warhog/fpvlaptracker-hardware/README.md

# fpvlaptracker-hardware
Hardware section of the fpvlaptracker project

**the current active project is fpvlaptracker32**
