warhog/fpvlaptracker-hardware/fpvlaptracker/schematics.png

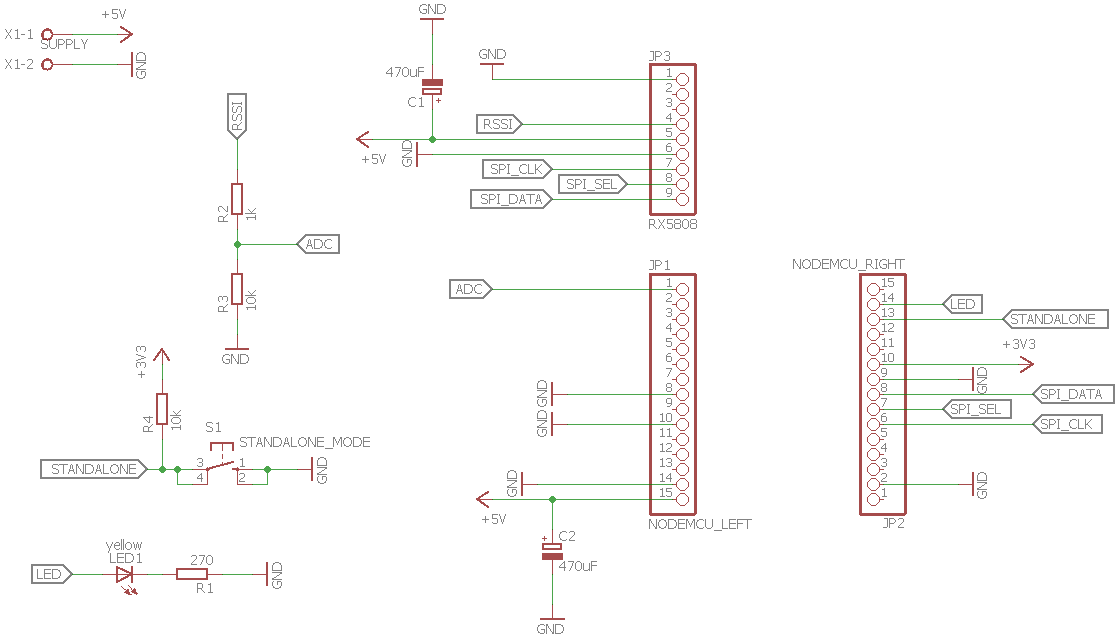
fpvlaptracker/schematics.png
