warhog/fpvlaptracker-hardware/fpvlaptracker/fpvlaptracker case.stl

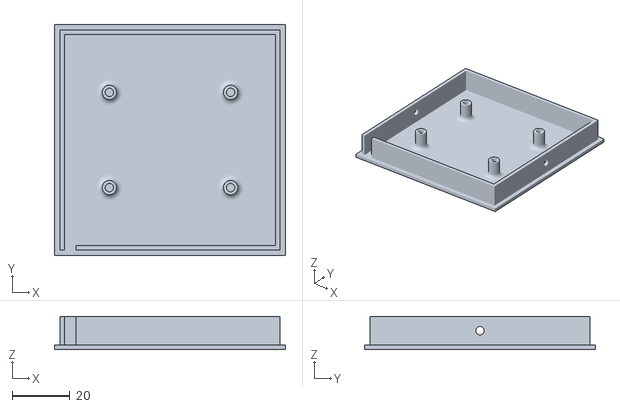
[picture p6: CAD file, 2018-08-29]
fpvlaptracker/fpvlaptracker case.stl
80.0 x 80.0 x 11.6
