warhog/fpvlaptracker-hardware/fpvlaptracker32/housing/fpvlaptracker32 case lid.stl

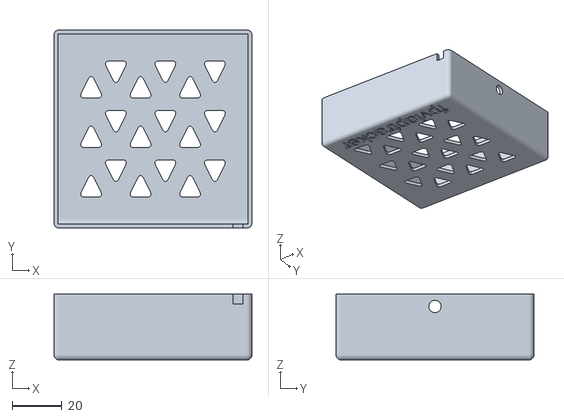
[picture p7: CAD file, 2019-03-24]
fpvlaptracker32/housing/fpvlaptracker32 case lid.stl
80.0 x 80.0 x 26.6
