warhog/fpvlaptracker-hardware/fpvlaptracker32/housing/fpvlaptracker32 case.stl

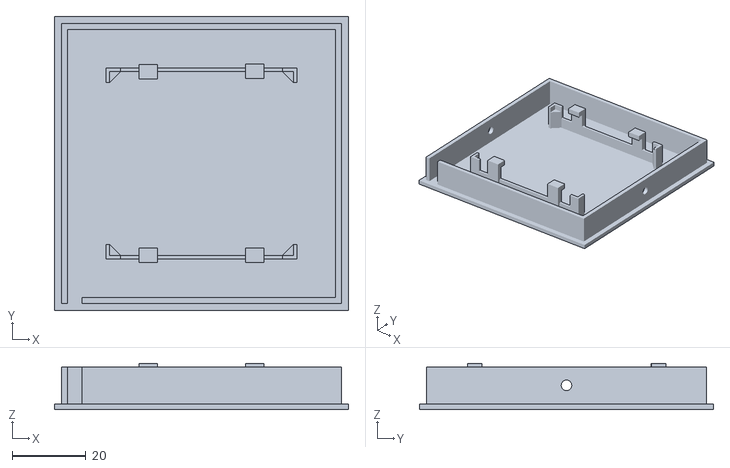
[picture p8: CAD file, 2019-03-24]
fpvlaptracker32/housing/fpvlaptracker32 case.stl
80.0 x 80.0 x 12.6
