warhog/fpvlaptracker-hardware/fpvlaptracker32/schematics/fpvlaptracker32.kicad_pcb

## KiCad design fpvlaptracker32/schematics/fpvlaptracker32.kicad_pcb (2019-03-25)

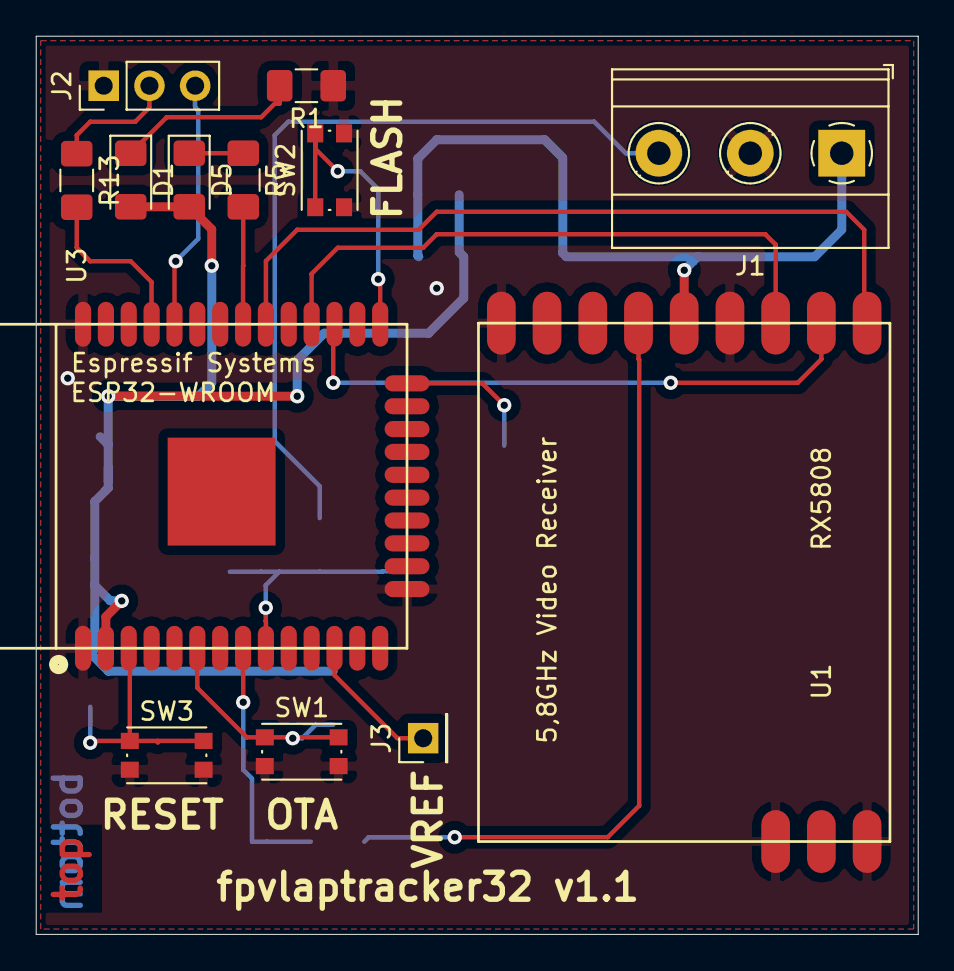
[picture p9: board fpvlaptracker32.kicad_pcb from above]

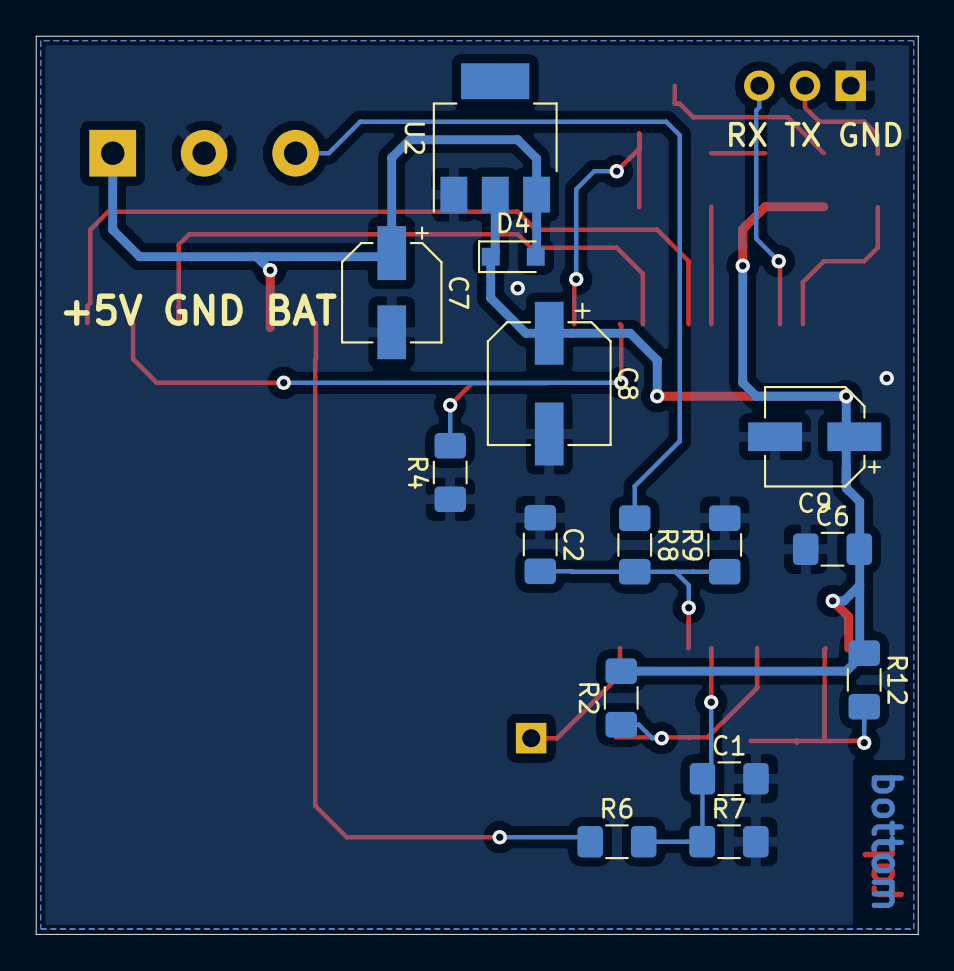
[picture p10: board fpvlaptracker32.kicad_pcb from below]

Board: 2 copper layers, 49.0 x 49.9 mm, 28 parts (15 on the bottom side), 21 nets.

Parts:
C1, C2, C6: 100nF; C_1206_3216Metric_Pad1.42x1.75mm_HandSolder
C7, C9: 10µF; CP_Elec_5x4.4
C8: 100µF; CP_Elec_6.3x5.4
D1, D5: LED; LED_1206_3216Metric_Pad1.42x1.75mm_HandSolder
D4: DIODE; D_SOD-323_HandSoldering
J1: Screw_Terminal_01x03; TerminalBlock_Phoenix_MKDS-1,5-3-5.08_1x03_P5.08mm_Horizont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
J2: Serial; PinHeader_1x03_P2.54mm_Vertical
J3: Conn_01x01_Female; PinHeader_1x01_P2.54mm_Vertical
R1, R9: 1k; R_1206_3216Metric_Pad1.42x1.75mm_HandSolder
R2, R6, R7, R8, R12: 10k; R_1206_3216Metric_Pad1.42x1.75mm_HandSolder
R4: 5k; R_1206_3216Metric_Pad1.42x1.75mm_HandSolder
R5: 100; R_1206_3216Metric_Pad1.42x1.75mm_HandSolder
R13: 470; R_1206_3216Metric_Pad1.42x1.75mm_HandSolder
SW1: Webupdate; SW_SPST_KMR2
SW2: Prog; SW_SPST_KMR2
SW3: Reset; SW_SPST_KMR2
U1: RX5808
U2: LM1117-3.3; SOT-223
U3: ESP-32_WROOM32; ESP32-WROOM

Connections:
+3V3: C6.2, C8.1, C9.1, D1.2, D4.1, D5.2, R2.2, R12.1, U2.2, U3.2
+5V: C7.1, D4.2, J1.1, U1.8, U2.3
/ADC_REF: J3.1, U3.12
/ANALOG_BAT: C2.2, R8.2, R9.1, U3.9
/ANALOG_RSSI: C1.1, R6.2, R7.1, U3.8
/BAT: J1.3, R8.1
/EN: R12.2, SW3.1, U3.3
/IO0: SW2.1, U3.25
/LED: R5.2, U3.31
/RSSI: R6.1, U1.9
/RXD: J2.3, U3.34
/SPI_CLK: U1.6, U3.28
/SPI_CS: U1.5, U3.27
/SPI_DATA: U1.4, U3.30
/TXD: J2.2, R13.1
/WEB_UPDATE: R2.1, SW1.1, U3.6
GND: C1.2, C2.1, C6.1, C7.2, C8.2, C9.2, J1.2, J2.1, R1.1, R4.1, R7.2, R9.2, SW1.2, SW2.2, SW3.2, U1.1, U1.3, U1.7, U1.12, U2.1, U3.1, U3.15, U3.38
unnamed: D1.1, R1.2
unnamed: D5.1, R5.1
unnamed: R4.2, U3.24
unnamed: R13.2, U3.35
