warhog/fpvlaptracker-hardware/fpvlaptracker/flt.brd

## EAGLE design fpvlaptracker/flt.brd (2018-08-29)

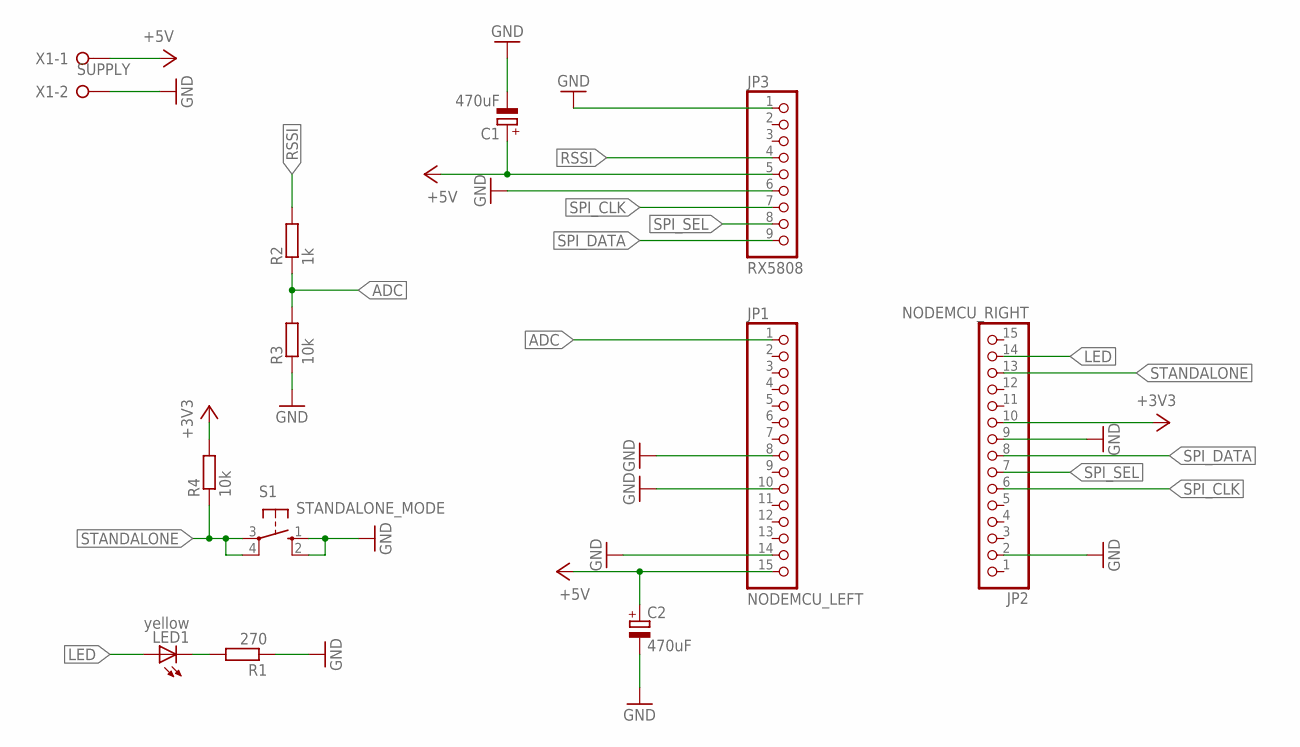
[picture p11: schematic flt.sch]

Parts:
C1, C2: 470uF; E5-8,5
JP1: NODEMCU_LEFT; 1X15
JP2: NODEMCU_RIGHT; 1X15
JP3: RX5808; 1X09
LED1: yellow; LED5MM
R1: 270; 0204/7
R2: 1k; 0204/7
R3, R4: 10k; 0204/7
S1: STANDALONE_MODE; B3F-10XX
X1: SUPPLY; W237-132

Connections:
+3V3: JP2.10, R4.2
+5V: C1.+, C2.+, JP1.15, JP3.5, X1.1
ADC: JP1.1, R2.1, R3.2
GND: C1.-, C2.-, JP1.8, JP1.10, JP1.14, JP2.2, JP2.9, JP3.1, JP3.6, R1.1, R3.1, S1.1 (S), S1.2 (S1), X1.2
LED: JP2.14, LED1.A
unnamed: LED1.K (C), R1.2
RSSI: JP3.4, R2.2
SPI_CLK: JP2.6, JP3.7
SPI_DATA: JP2.8, JP3.9
SPI_SEL: JP2.7, JP3.8
STANDALONE: JP2.13, R4.1, S1.3, S1.4 (P1)

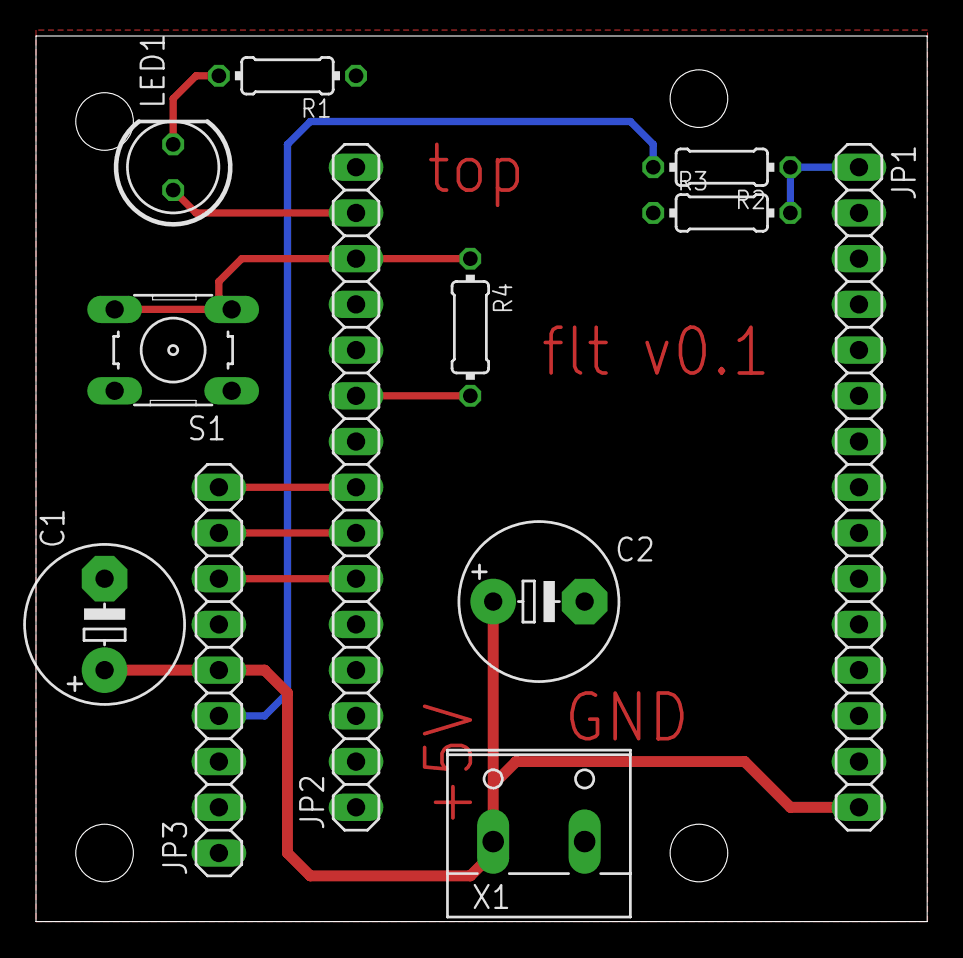
[picture p12: board flt.brd from above]

Board: 2 copper layers, 49.5 x 49.2 mm, 12 parts (0 on the bottom side), 11 nets.
