warhog/fpvlaptracker-hardware/(commit log)

2018-09-29 updated rev1.1
    [fpvlaptracker32 case.stl, fpvlaptracker32 key.stl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]
2018-09-29 added bom
    [fpvlaptracker32-bom.csv]
2018-10-26 added readme
    [fpvlaptracker32-bom.csv]
2019-02-23 changed r6 to 1k to increase resolution
    [fpvlaptracker32.sch]
2019-03-24 updated case (smaller, better cable outlet
    [fpvlaptracker32 case lid.stl, fpvlaptracker32 case.stl]
2019-03-25 fix footprint of switched on schematic
    [fpvlaptracker32.kicad_pcb, fpvlaptracker32.sch]
